Kuwamai/micromouse_ocelli/circuit_diagram/block_diagram.drawio.png

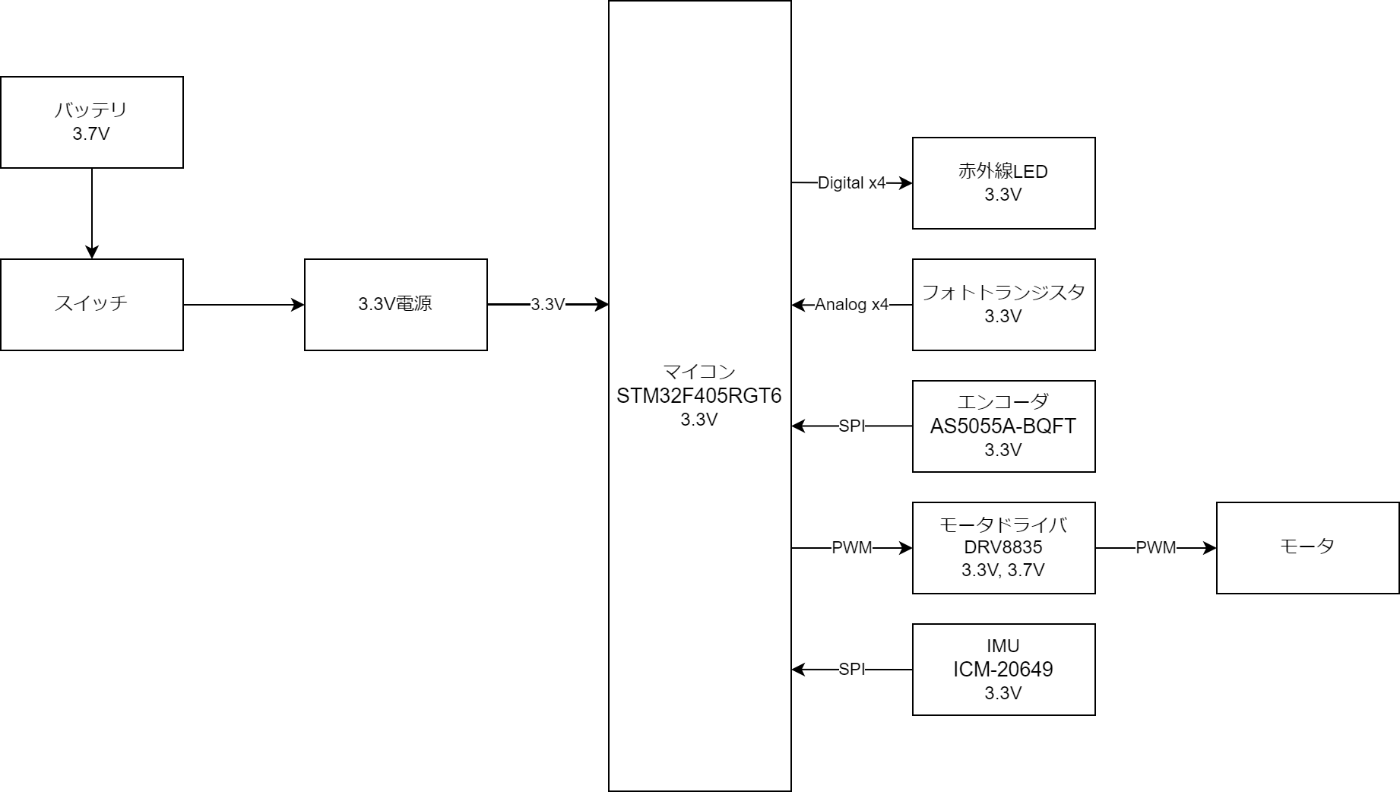
circuit_diagram/block_diagram.drawio.png
