Kuwamai/micromouse_ocelli/circuit_diagram/ocelli_board.dxf

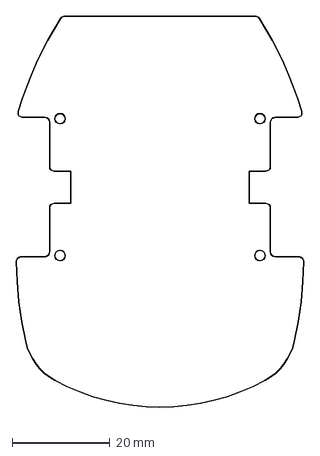
[picture p2: CAD file, 2022-10-17]
circuit_diagram/ocelli_board.dxf
58.8 x 81.8 mm
