Kuwamai/micromouse_ocelli/circuit_diagram/ocelli_parts.dxf

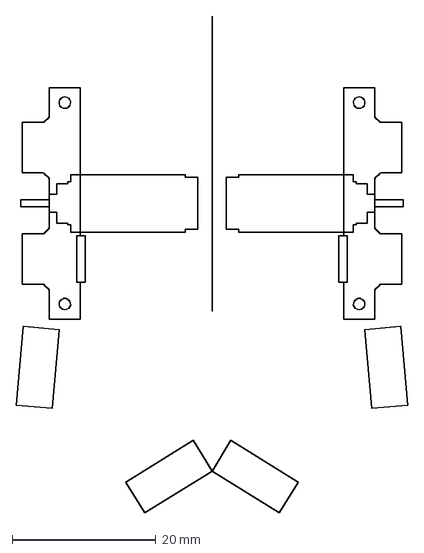
[picture p3: CAD file, 2022-10-17]
circuit_diagram/ocelli_parts.dxf
54.4 x 69.0 mm
