Kuwamai/micromouse_ocelli/(threads)

Thread 12 (2021-10-04):

機体設計

Kuwamai, 2021-10-04:
- [x] ネジの選定
    - [鉄(三価クロメート) ＋低頭精密小ねじ(ラミクス) FX-0000E【ウィルコ-WILCO-】ねじ(ネジ)の通販・販売](https://wilco.jp/products/F/FX-E.html#page3)
    - [ネジやボルトの必要最低長さ計算方法 | alumania INFORMATION](https://info.alumania.net/diy/%E3%83%8D%E3%82%B8%E9%95%B7%E3%81%95%E3%81%AE%E7%B0%A1%E6%98%93%E8%A8%88%E7%AE%97%E6%96%B9%E6%B3%95%E3%81%A8%E6%97%A9%E8%A6%8B%E8%A1%A8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)
        - ネジの長さはネジ径x1.5なのでM2ネジ長さは3mm
- [x] モータマウントの外形決め
- [x] センサ配置検討
- [x] 基板のおおよそのサイズ決定

Kuwamai, 2021-11-04:
基板の厚さは標準的な1.6mm
迷路内の段差は最大1mmあるので車高はそれ以上にする

Kuwamai, 2022-04-13:
Fusion360を使った設計の流れ
* [Fusion360で設計するマイクロマウス①：マウス研修（しおたに）32 | アールティ　移動型ロボットブログ](https://rt-net.jp/mobility/archives/13979)
* [Fusion360で設計するマイクロマウス②：マウス研修（しおたに）33 | アールティ　移動型ロボットブログ](https://rt-net.jp/mobility/archives/13981)
* [Fusion360で設計するマイクロマウス③：マウス研修（しおたに）34 | アールティ　移動型ロボットブログ](https://rt-net.jp/mobility/archives/14798)
* [Fusion360で設計するマイクロマウス④：マウス研修（しおたに）35 | アールティ　移動型ロボットブログ](https://rt-net.jp/mobility/archives/15145)

Kuwamai, 2022-04-13:
エンコーダの配置を決めるためモータマウントを優先して設計
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

Kuwamai, 2022-04-13:
エンコーダの配置参考
* [ショウのマイクロマウス制作-Part19 | アールティ　移動型ロボットブログ](https://rt-net.jp/mobility/archives/16338)
* [ショウのマイクロマウス制作-Part31 | アールティ　移動型ロボットブログ](https://rt-net.jp/mobility/archives/20573)

Closed 2023-02-21.

Thread 3 (2021-10-04):

ギヤ比、歯数を決める

Kuwamai, 2021-10-04:
目標加速度、速度からギヤ比を決める
ホイールのサイズからスパーギヤの歯数を決める
モジュールは3Dプリンタで制作しやすい0.5にする

Kuwamai, 2021-11-02:
ギヤ比計算式: https://rt-net.jp/mobility/archives/12621
モータ: https://www.shinkoh-faulhaber.jp/products/series/0816sr
ギヤ比: 1.7
目標最高速度: 5m/s
目標最高加速度: 20m/s/s
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

Kuwamai, 2021-11-02:
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

Kuwamai, 2021-11-02:
スパーギヤが22の場合ギヤ比1.7を満たすピニオンは22/1.7=12.9411なので13になる。

Kuwamai, 2021-12-02:
最大加速度と最高速度を出力するために必要な電圧を別々に計算していたけど、台形加速で速度制御する際は最大加速度と最高速度を同時に出力する必要があった。そこでギヤ比を計算し直したところギヤ比3になった。もっと速度出せそうだったら2くらいにしてもいいかも。
ギヤ比: 3
機体重量: 0.05kg
最大加速度: 10m/s/s
最高速度: 1.6m/s
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

Kuwamai, 2021-12-02:
ギヤ比変更の影響でM0.5をM0.3に変更。DMMのプリントサービスを利用する。
https://make.dmm.com/print/material/2/

Kuwamai, 2021-12-02:
スパーギヤは11/0.3-2=34.666なので34
ピニオンギヤは34/3=11.333なので11

Kuwamai, 2021-12-07:
HMキットだとホイールの外寸は10mm。ゴムの厚みは1.8mmなのでタイヤ径は13.6mmがずれにくくていいかも。
https://www.rt-shop.jp/index.php?main_page=product_info&products_id=3643

Kuwamai, 2021-12-09:
HMキットを参考に車輪径を考慮しなおしたもの
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

Closed 2022-09-12.

Thread 4 (2021-10-04):

開発環境構築

Kuwamai, 2021-10-04:
- OpenOCD
  - [環境構築 – しゅうの自作マウス研修 part3 | アールティ　移動型ロボットブログ](https://rt-net.jp/mobility/archives/16130)
  - [Lチカ – しゅうの自作マウス研修 part4 | アールティ　移動型ロボットブログ](https://rt-net.jp/mobility/archives/16231)
  - [環境構築とLチカ （STM32/Makefile/VSCode） – 元Web屋のマウス製作記 Part.15 | アールティ　移動型ロボットブログ](https://rt-net.jp/mobility/archives/9940)
  - [STM32をVSCode & PlatformIO (C++) で開発する - いろいろつくるよ](https://iroiro-craft.hatenablog.com/entry/2022/06/04/172802)

- CubeIDE
  - [マイクロマウス研修(のり)[15]STM32F446開発環境構築 | アールティ　移動型ロボットブログ](https://rt-net.jp/mobility/archives/11816)
  - [マイクロマウス研修(のり)[16]STM32F446書込&デバッグ | アールティ　移動型ロボットブログ](https://rt-net.jp/mobility/archives/12122)

- OpenCFDの設定ファイルは`/usr/share/openocd/scripts`にある
  - [OpenOCD + ST-LinkでFirmware書き込み - ryochack.blog](https://ryochack.hatenablog.com/entry/2017/11/03/234216)
- 書き込み機の改造
  - [stlink\_usb.c:773 stlink\_usb\_init\_mode(): target voltage may be too low for reliable debugging](https://community.st.com/s/question/0D50X00009XkdhFSAR/stlinkusbc773-stlinkusbinitmode-target-voltage-may-be-too-low-for-reliable-debugging)

Kuwamai, 2023-01-12:
Nucleo boardの上半分とOpenOCDによる書き込みを試したが何故か失敗するのでCubeIDEを使用して開発を進める

Kuwamai, 2023-02-01:
Cube IDEのインデント幅設定。BSD/Allmanのインデント幅を2にした。
- [STM32 IDE 知って得する小技たち │ moon's STM32づくし](https://moons.link/post-1143/)

Closed 2023-01-12.

Thread 6 (2021-10-04):

ADC

Kuwamai, 2021-10-04:
壁センサや電圧監視の動作確認

Kuwamai, 2023-02-02:
- [マイクロマウス研修(のり)[32]STM32F446 STEP3-1 ADC(シングル) | アールティ　移動型ロボットブログ](https://rt-net.jp/mobility/archives/19081)
- [マイクロマウス研修(のり)[33]STM32F446 STEP3-2 ADC(複数チャンネル) | アールティ　移動型ロボットブログ](https://rt-net.jp/mobility/archives/19153)
  - とりあえずこれで実装してみる
- [マイクロマウス研修(のり)[34]STM32F446 STEP3-3 ADC(DMA) | アールティ　移動型ロボットブログ](https://rt-net.jp/mobility/archives/19257)

Kuwamai, 2023-02-06:
コレクタ-エミッタ間
3.299->3.209

GND-エミッタ間
34->511mv

GND-アナログピン間
0mv?

Kuwamai, 2023-02-07:
フォトトランジスタの立ち上がりまでの時間やdelay_usについて記述

Kuwamai, 2023-02-08:
正確なdelay関数を作りたい
参考: [Microsecond/Nanoseconds delay in STM32 » ControllersTech](https://controllerstech.com/create-1-microsecond-delay-stm32/)
TIM1は使ってるのでTIM2にする。TIM2はAPB1を使っており84MHz。prescaler 84-1で作成。
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

Kuwamai, 2023-02-08:
- [マイクロマウス研修(のり)[34]STM32F446 STEP3-3 ADC(DMA) | アールティ　移動型ロボットブログ](https://rt-net.jp/mobility/archives/19257)
- DMAのやつにした
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

Closed 2023-02-12.

Thread 7 (2021-10-04):

PWM

Kuwamai, 2021-10-04:
- [STM32でDCモータを回す – 元Web屋のマイクロマウス製作記 Part.18 | アールティ　移動型ロボットブログ](https://rt-net.jp/mobility/archives/10557)
  - PWM周波数[Hz] = （クロックソース[Hz] / プリスケーラ） / カウンタピリオド
  - PWM(200kHz) = (16Mhz / 16) / 5
- AHB ClockはMAXまで上げて問題ない
  - 多少消費電流が増えるがバッテリが小さくなければOK
  - 16 MHz→168 MHz

Kuwamai, 2023-01-12:
PWM周波数1kHz
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
↓
PWM周波数168kHz
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

Kuwamai, 2023-01-12:
```
  while (1)
  {
    HAL_GPIO_TogglePin(GPIOC, GPIO_PIN_6);
    HAL_GPIO_TogglePin(GPIOC, GPIO_PIN_7);
    //HAL_GPIO_TogglePin(GPIOC, GPIO_PIN_8);
    //HAL_GPIO_TogglePin(GPIOC, GPIO_PIN_9);
    HAL_GPIO_TogglePin(GPIOA, GPIO_PIN_10);
    __HAL_TIM_SET_COMPARE(&htim1, TIM_CHANNEL_4, 250);
    HAL_TIM_PWM_Start(&htim1, TIM_CHANNEL_4);
    HAL_GPIO_TogglePin(GPIOA, GPIO_PIN_8);
    __HAL_TIM_SET_COMPARE(&htim1, TIM_CHANNEL_2, 250);
    HAL_TIM_PWM_Start(&htim1, TIM_CHANNEL_2);
    HAL_Delay(1000);
    HAL_TIM_PWM_Stop(&htim1, TIM_CHANNEL_4);
    HAL_TIM_PWM_Stop(&htim1, TIM_CHANNEL_2);
    HAL_Delay(1000);
    /* USER CODE END WHILE */

    /* USER CODE BEGIN 3 */
  }
```

Kuwamai, 2023-01-12:
- TIM1のクロック
  - https://www.st.com/resource/en/datasheet/dm00037051.pdf 19P
- DRV8835のPWM周波数上限
  - https://www.ti.com/jp/lit/ds/symlink/drv8835.pdf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 P5

Kuwamai, 2023-01-12:
- その他ブログネタ
  - モータの出力軸根本についている出っ張りがモータ本体に固定されていると思ったら出力軸側だった
  - 出っ張りとモータマウンタを接触させて位置合わせしていたためモータをモータマウンタに固定するとモータが回転しなくなってしまった
  - 位置合わせ用の穴を2.5mm→3mmに拡大して出っ張りとモータマウンタの接触を修正した
  - モータの配線はコネクタ使ったほうがいいよねの話
  - モータの配線に熱収縮チューブつければよかったねの話

Closed 2023-01-12.

Thread 8 (2021-10-04):

IMU

Kuwamai, 2021-10-04:
- ICM-20649データセット
  - https://product.tdk.com/system/files/dam/doc/product/sensor/mortion-inertial/imu/data_sheet/ds-000192-icm-20649-v1.1.pdf
  - MSB【Most Significant Bit】
  - LSB【Least Significant Bit】

Kuwamai, 2023-01-13:
まずはセンサ値を確認するためデバッグモードの動作確認をした
- [マイクロマウス研修(のり)[16]STM32F446書込&デバッグ | アールティ　移動型ロボットブログ](https://rt-net.jp/mobility/archives/12122)
- [STM32CubeIDEでのデバッグ - Qiita](https://qiita.com/infinite1oop/items/98e512adbeadc7136efe)
```
  while (1)
  {
    HAL_GPIO_TogglePin(GPIOC, GPIO_PIN_6);
    HAL_GPIO_TogglePin(GPIOC, GPIO_PIN_7);
    for(int i = 0; i < 5; i++)
    {
      HAL_GPIO_TogglePin(GPIOC, GPIO_PIN_8);
      HAL_GPIO_TogglePin(GPIOC, GPIO_PIN_9);
      HAL_Delay(200);
    }
    /*
    HAL_GPIO_TogglePin(GPIOA, GPIO_PIN_10);
    __HAL_TIM_SET_COMPARE(&htim1, TIM_CHANNEL_4, 250);
    HAL_TIM_PWM_Start(&htim1, TIM_CHANNEL_4);
    HAL_GPIO_TogglePin(GPIOA, GPIO_PIN_8);
    __HAL_TIM_SET_COMPARE(&htim1, TIM_CHANNEL_2, 250);
    HAL_TIM_PWM_Start(&htim1, TIM_CHANNEL_2);
    HAL_Delay(1000);
    HAL_TIM_PWM_Stop(&htim1, TIM_CHANNEL_4);
    HAL_TIM_PWM_Stop(&htim1, TIM_CHANNEL_2);
    HAL_Delay(1000);
    */
    /* USER CODE END WHILE */

    /* USER CODE BEGIN 3 */
  }
```

Kuwamai, 2023-01-13:
- [マイクロマウス研修(のり)[39]STM32F446 STEP7-1 SPI | アールティ　移動型ロボットブログ](https://rt-net.jp/mobility/archives/19984)
- データセットと照らし合わせながら設定方法を解説している
- 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
- PWMと違って通信速度が表示されるのでいい
- 僕は7MHzが上限なので8を設定

Kuwamai, 2023-01-16:
のりさんのコードのアドレス部分を書き換えたらWHO_AM_Iできた
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

Kuwamai, 2023-01-18:
- [マイクロマウス研修(のり)[39]STM32F446 STEP7-2 SPI(IMU) | アールティ　移動型ロボットブログ](https://rt-net.jp/mobility/archives/20145)
  - 引き続きのりさんのブログを見て角速度が取得できた

Kuwamai, 2023-01-18:
gitignoreは基本的にEclipseのものでOK
https://github.com/github/gitignore/blob/main/Global/Eclipse.gitignore

Kuwamai, 2023-01-18:
```
  /* USER CODE BEGIN WHILE */
  while (1)
  {
    HAL_GPIO_TogglePin(GPIOC, GPIO_PIN_6);
    HAL_GPIO_TogglePin(GPIOC, GPIO_PIN_7);

    address = 0x37 | 0b10000000;
    HAL_GPIO_WritePin(GPIOD, GPIO_PIN_2, GPIO_PIN_RESET);
    HAL_SPI_Transmit(&hspi3, &address, 1, 100);
    HAL_SPI_Receive(&hspi3, &data_h, 1, 100);
    HAL_GPIO_WritePin(GPIOD, GPIO_PIN_2, GPIO_PIN_SET);
    HAL_Delay(50);

    address = 0x38 | 0b10000000;
    HAL_GPIO_WritePin(GPIOD, GPIO_PIN_2, GPIO_PIN_RESET);
    HAL_SPI_Transmit(&hspi3, &address, 1, 100);
    HAL_SPI_Receive(&hspi3, &data_l, 1, 100);
    HAL_GPIO_WritePin(GPIOD, GPIO_PIN_2, GPIO_PIN_SET);
    HAL_Delay(50);

    gyro_z = ((int16_t)((uint16_t)data_h<<8)) | ((int16_t)((uint16_t)data_l&0x00ff));
    gyro_z_ang_vel = (float)gyro_z / 65.5;
  }
```

Kuwamai, 2023-01-20:
- [ESP32マウスPart.37　C++でESP32を動かす（SPIでモーションセンサと通信する） | アールティ　移動型ロボットブログ](https://rt-net.jp/mobility/archives/10865)
- [ESP32マウスPart.38　C++でESP32を動かす（ICM-20648のライブラリ作成） | アールティ　移動型ロボットブログ](https://rt-net.jp/mobility/archives/11487)
- [モータ周りとIMUの回路設計– はしもとの自作マウス研修 Part13 | アールティ　移動型ロボットブログ](https://rt-net.jp/mobility/archives/22017)
- [ジャイロってなんじゃろ？– HM-StarterKit入門 Part 9 | アールティ　移動型ロボットブログ](https://rt-net.jp/mobility/archives/17327)
- [ドライバとコントローラの実装 – ししかわのマウス研修 Part.46 | アールティ　移動型ロボットブログ](https://rt-net.jp/mobility/archives/16072)
- [M5Mouse/gyro.c at master · meganetaaan/M5Mouse](https://github.com/meganetaaan/M5Mouse/blob/master/mouse/Core/Src/drivers/gyro.c)
- [マイクロマウス研修（kora編）[8]ジャイロとエンコーダ | アールティ　移動型ロボットブログ](https://rt-net.jp/mobility/archives/6396)

Closed 2023-01-19.

Thread 9 (2021-10-04):

エンコーダ

Kuwamai, 2021-10-04:
* 5047の記事
  * [マイクロマウスの磁気式エンコーダの設計をしてみる | Sora's Activity Record](https://garberas.com/archives/2218)
  * [AS5047P | ams](https://ams.com/ja/as5047p#tab/documents)
  * [data sheet](https://ams.com/documents/20143/36005/AS5047P_DS000324_3-00.pdf)
* [AS5055A Small size, low power rotary position sensor, hall sensor - ams | ams](https://ams.com/ja/as5055a#tab/documents)
  * 購入したエンコーダ
  * [data sheet](https://ams.com/documents/20143/36005/AS5055A_DS000304_2-00.pdf/edb580b0-2a7b-ba9f-1b35-139255db4272)
* HM-Kitは5050
  * [ハーフマウス研修　その13エンコーダの再選定 | アールティ　移動型ロボットブログ](https://rt-net.jp/mobility/archives/4192)
* [Magnet Selection Guide](https://ams.com/documents/20143/36005/AnglePositionOnAxis_AN000271_2-00.pdf/d3bc1235-a3da-7e15-15bf-624e9ff0c389)

Kuwamai, 2022-04-18:
* [マイクロマウスの磁気式エンコーダの設計をしてみる | Sora's Activity Record](https://garberas.com/archives/2218)
  * 磁石サイズや距離、モータマウントの設計、市販の部品など紹介されている
* [マイクロマウス導入技術～磁気式エンコーダ～ | Haratta Tech Lab](https://haratta-tech-lab.com/magnetic-encoder/)
  * エンコーダの線形性、精度について紹介されている
* [磁気式エンコーダ　その１ - エヌがのロボット製作日記](https://megato.hatenablog.com/entry/2015/11/29/023020)
* [磁気式エンコーダ　その２ - エヌがのロボット製作日記](https://megato.hatenablog.com/entry/2015/11/29/171715)
* [磁気式エンコーダ　その３ - エヌがのロボット製作日記](https://megato.hatenablog.com/entry/2015/12/04/035435)
  * センサの補正についてまとめられている
  * モータを互い違いに配置している
* [まついのまうす製作録: AS5040のマウス用途開発(1)](http://matsui-mouse.blogspot.com/2012/11/as50401.html)
* [まついのまうす製作録: AS5040のマウス用途開発(2)](http://matsui-mouse.blogspot.com/2012/12/as50402.html)
* [まついのまうす製作録: AS5040のマウス用途開発(3)](http://matsui-mouse.blogspot.com/2012/12/as50403_24.html)
  * エンコーダ用基板とメイン基板をつなぐパッド位置などまとめられている

Kuwamai, 2023-01-16:
HIGHではなくLOWかも

Kuwamai, 2023-01-20:
HM-KitがASシリーズ使ってるらしいのでAS5055買ったけど、みんなMA702使ってるし現行のHM-KitもMA702だったよトホホ〜

Kuwamai, 2023-01-26:
- Live Expressionでリアルタイムに値を確認できる
- [STM32CubeIDEを使ってみよう　How To STM32CubeIDE 日本語版　(3) - Qiita](https://qiita.com/usashirou/items/e1cb59a508dac64b8a3c)

Kuwamai, 2023-01-26:
こうすれば16 bit送れる？
[Send 16 bit number with SPI and HAL library](https://community.st.com/s/question/0D50X00009Xkf5JSAR/send-16-bit-number-with-spi-and-hal-library)

Kuwamai, 2023-01-27:
クロックを確認したらGNDが浮いているような挙動をしている。MISOとSCLKがショートしているようなので要確認。
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

Kuwamai, 2023-01-27:
IMUは最初の8bitでアドレス、それ以降のクロックでデータを送り返す仕様になっていた。そのためTransmitとReceiveは別に表記されていた。↑のクロックが複数あるのはそのせい。

エンコーダは受信のために一度CSを立ち上げる必要がある（P11）
受信と送信が同時に行われる（P15とかFigure17とか。）
そのためTransmitとReceiveを別に実行せず同時に実行する必要がある。

Kuwamai, 2023-01-30:
ショートしてそうな場所を見つけたので除去した。テスターで確認したところショートしてないっぽい

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

Kuwamai, 2023-02-01:
これで値がとれた
```
int16_t encoder_l;
int16_t encoder_r;
uint16_t data;
  while (1)
  {
    HAL_GPIO_TogglePin(GPIOC, GPIO_PIN_6);
    HAL_GPIO_TogglePin(GPIOC, GPIO_PIN_7);
    uint16_t address = 0xFFFF;

    HAL_GPIO_WritePin(GPIOC, GPIO_PIN_1, GPIO_PIN_RESET);
    HAL_SPI_TransmitReceive(&hspi2, (uint8_t*)&address, (uint8_t*)&data, 1, 100);
    HAL_GPIO_WritePin(GPIOC, GPIO_PIN_1, GPIO_PIN_SET);
    HAL_Delay(50);
    encoder_l = (data & 0b0011111111111100) >> 2;

    HAL_GPIO_WritePin(GPIOC, GPIO_PIN_13, GPIO_PIN_RESET);
    HAL_SPI_TransmitReceive(&hspi2, (uint8_t*)&address, (uint8_t*)&data, 1, 100);
    HAL_GPIO_WritePin(GPIOC, GPIO_PIN_13, GPIO_PIN_SET);
    HAL_Delay(50);
    encoder_r = (data & 0b0011111111111100) >> 2;
    /* USER CODE END WHILE */

    /* USER CODE BEGIN 3 */
  }
```

Kuwamai, 2023-02-01:
角度読むだけだと不要だけどパリティビットの計算方法
- [C#講座　RS405CB動く！ | RT Robot Shop Blog](https://www.rt-shop.jp/blog/archives/3272)
- [効率の良いパリティ計算方法 - Qiita](https://qiita.com/shiozaki/items/e803483cbd8b3c6ab28d)
- [パリティビットの意味と誤り検出、誤り訂正の方法 - 具体例で学ぶ数学](https://mathwords.net/paritycheck)

Closed 2023-02-01.

Thread 13 (2022-07-06):

回路図作成

Kuwamai, 2022-07-06:
モジュールごとに設計する
- [x] フォトリフレクタ
    - [５ｍｍ赤色ＬＥＤ　６２４ｎｍ　１５度　ＯＳ５ＲＫＡ５１１１Ａ　（１０個入）: LED(発光ダイオード) 秋月電子通商-電子部品・ネット通販](https://akizukidenshi.com/catalog/g/gI-04768/)
    - [コーデンシ製フォトトランジスタST-1KL3A　4個入り [ST-1KL3A\_4] - ￥1,320](https://www.rt-shop.jp/index.php?main_page=product_info&products_id=2746)
    - [ＮｃｈＭＯＳＦＥＴ　５０Ｖ３００ｍＡ　ＢＳＳ１３８　Ｐａｎｊｉｔ製　（２５個入）: 半導体(モジュール) 秋月電子通商-電子部品・ネット通販](https://akizukidenshi.com/catalog/g/gI-04232/)
    - 板Pi:Coと同じ構成
- [x] モータドライバ
    - 参考: [M5Stackマイクロマウスの回路設計：DRV8835を使ったモータドライバ回路 – ししかわのマウス研修 Part.35 | アールティ　移動型ロボットブログ](https://rt-net.jp/mobility/archives/14884)
    - [DRV8835 のデータシート、製品情報、およびサポート | TI.com](https://www.ti.com/product/ja-jp/DRV8835)
- [x] IMU
    - 参考: [M5Stackマイクロマウスの回路設計：ICM-20648を使ったIMU回路 – ししかわのマウス研修 Part.36 | アールティ　移動型ロボットブログ](https://rt-net.jp/mobility/archives/15211)
    - SPI通信の略語: [マイクロマウス研修(のり)[39]STM32F446 STEP7-1 SPI | アールティ　移動型ロボットブログ](https://rt-net.jp/mobility/archives/19984)
    - [Data sheet: Typical Operating Circuit](https://product.tdk.com/system/files/dam/doc/product/sensor/mortion-inertial/imu/data_sheet/ds-000192-icm-20649-v1.0.pdf)
- [x] エンコーダ
    - [AS5055A Small size, low power rotary position sensor, hall sensor - ams | ams](https://ams.com/ja/as5055a)
    - [ESP32マウスPart.36　SPIで磁気式エンコーダMA702を使う | アールティ　移動型ロボットブログ](https://rt-net.jp/mobility/archives/10454)
    - [ショウのマイクロマウス制作-Part29 | アールティ　移動型ロボットブログ](https://rt-net.jp/mobility/archives/19171)
    - IMUとエンコーダのSPIをわけておくと万が一仕様が異なっていても大丈夫
- [x] マイコン
    - [STM32F405RGT6｜製品情報（STM32）｜STM32, STM8ファミリはSTの32bit／8bit汎用マイクロコントローラ製品](https://www.stmcu.jp/stm32/stm32f4/stm32f405415/12229/)
    - 書き込みコネクタ
        - [M5Stackマイクロマウスの回路設計：M5StackとSTM32周辺回路 – ししかわのマウス研修 Part.37 | アールティ　移動型ロボットブログ](https://rt-net.jp/mobility/archives/15317)
        - [マイクロマウス研修(のり)[2]STM32F446データシート | アールティ　移動型ロボットブログ](https://rt-net.jp/mobility/archives/10003)
        - [マイクロマウス研修(のり)[3]STM32F446回路設計 | アールティ　移動型ロボットブログ](https://rt-net.jp/mobility/archives/10171)
            - マイコンへの電源供給まわりも参考にした
        - [ショウのマイクロマウス制作-Part18 | アールティ　移動型ロボットブログ](https://rt-net.jp/mobility/archives/16024)
        - [書き込み用ピン - P30](https://www.st.com/content/ccc/resource/technical/document/application_note/76/f9/c8/10/8a/33/4b/f0/DM00115714.pdf/files/DM00115714.pdf/jcr:content/translations/en.D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)
        - [NUCLEO boardをST-Linkとして使う - P19](https://www.st.com/resource/en/user_manual/um1724-stm32-nucleo64-boards-mb1136-stmicroelectronics.pdf)
    - 書き込み時の出力(reset value)を気にしないと書き込むたびにマウスが走り出したりする
        - P287
        - https://www.st.com/resource/en/reference_manual/dm00031020-stm32f405-415-stm32f407-417-stm32f427-437-and-stm32f429-439-advanced-arm-based-32-bit-mcus-stmicroelectron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
- [x] LED
    - [赤色チップＬＥＤ　［１６０８］　６２５ｎｍ　１２０度　ＯＳＨＲ１６０８　（２０個入）: LED(発光ダイオード) 秋月電子通商-電子部品・ネット通販](https://akizukidenshi.com/catalog/g/gI-03978/)
    - [青色チップＬＥＤ　［１６０８］　ＯＳＢＬ１６０８　（２０個入）: LED(発光ダイオード) 秋月電子通商-電子部品・ネット通販](https://akizukidenshi.com/catalog/g/gI-03982/)
    - [黄色チップＬＥＤ　［１６０８］　ＯＳＹＬ１６０８　（２０個入）: LED(発光ダイオード) 秋月電子通商-電子部品・ネット通販](https://akizukidenshi.com/catalog/g/gI-03984/)
        - 黄色と青のカラフルな感じに出来たらいいな
- [x] 電源
    - [低損失表面実装型三端子レギュレーター　３．３Ｖ８００ｍＡ　ＮＪＭ２８４５ＤＬ１－３３: 半導体(モジュール) 秋月電子通商-電子部品・ネット通販](https://akizukidenshi.com/catalog/g/gI-11299/)
    - [ＰｃｈパワーＭＯＳＦＥＴ　６０Ｖ８Ａ　ＴＪ８Ｓ０６Ｍ３Ｌ: 半導体(モジュール) 秋月電子通商-電子部品・ネット通販](https://akizukidenshi.com/catalog/g/gI-13964/)
    - 板Pi:Coを参考
- [x] スイッチ
    - [表面実装用タクトスイッチ　ＴＳ－０６１０４: パーツ一般 秋月電子通商-電子部品・ネット通販](https://akizukidenshi.com/catalog/g/gP-15969/)
- [x] ブザー
    - [表面実装圧電サウンダ　ＰＫＭＣＳ０９０９Ｅ４０００－Ｒ１: パーツ一般 秋月電子通商-電子部品・ネット通販](https://akizukidenshi.com/catalog/g/gP-14238/)
    - 板Pi:Co参考
- [x] ~~水晶発振子~~
    - USB通信等クロックに高い精度が求められることをしないので今回は使用しない
    - [クリスタル（水晶振動子）　８ＭＨｚ　（５個入）: パーツ一般 秋月電子通商-電子部品・ネット通販](https://akizukidenshi.com/catalog/g/gP-17131/)
    - [表面実装型クリスタル（水晶発振子）　８ＭＨｚ　（５個入）: パーツ一般 秋月電子通商-電子部品・ネット通販](https://akizukidenshi.com/catalog/g/gP-01340/)
    - [表面実装型クリスタル（水晶発振子）　３２．７６８ｋＨｚ　（４個入）: パーツ一般 秋月電子通商-電子部品・ネット通販](https://akizukidenshi.com/catalog/g/gP-03004/)
- [x] バッテリー
    - [300mAh](https://www.amazon.co.jp/dp/B09B4T26YX?ref_=cm_sw_r_cp_ud_dp_KEJTHVFV9VXGP1RECBQ0)
- [x] フェライトビーズ
    - [MZ1608-102Y Bourns Inc. | フィルタ | DigiKey](https://www.digikey.jp/ja/products/detail/bourns-inc/MZ1608-102Y/1970477)
    - 参考: [マイクロマウス研修(のり)[8]KiCAD部品表出力 | アールティ　移動型ロボットブログ](https://rt-net.jp/mobility/archives/10774)

Kuwamai, 2022-07-07:
回路設計の進め方
1. 回路ブロック図を考える
2. ブロックごとに主要なICを選定してブロック図に書き込んでいく
3. ブロックごとに回路設計を行う
    - ICのサンプル回路が参考になると思う
    - Pin functionのページに接続する部品が書いてあったりするのでそちらも参考に
    - 抵抗やコンデンサなど細かい素子の選定は置いておく
    - 他のモジュールと共通してる場合があるため
    - 同じ容量のコンデンサが4種類あるとか避けたい

Kuwamai, 2022-07-20:
KiCAD用gitignore
* [gitignore/Unity.gitignore at main · github/gitignore](https://github.com/github/gitignore/blob/main/Unity.gitignore)

Kuwamai, 2022-08-17:
参考回路図
- [M5Mouse/m5mouse.pdf at master · meganetaaan/M5Mouse](https://github.com/meganetaaan/M5Mouse/blob/master/schematics/m5mouse/m5mouse.pdf)

Kuwamai, 2022-08-29:
- 抵抗
    - 抵抗値、定格電力、精度
    - [【抵抗器】電子工作で最もよく使われる部品の一つ | 電子工作[超]入門 Lab.](https://sanuki-tech.net/make-electronics/parts/resistor/)
        - 抵抗の定格電力は消費電力の倍以上にしておく
        - 余裕をもたせることをディレーティングという
        - 消費電力は`P = V * V / R`で求める
    - [抵抗の適切な選定方法｜EMC村の民](https://engineer-climb.com/resistor-choice/)
        - 抵抗値が大きい場合は最高過負荷電圧も気にする
- コンデンサ
    - 容量、耐圧、精度

Closed 2022-09-01.

Thread 15 (2022-09-12):

回路パターン作成

Kuwamai, 2022-09-12:
- [x] 基板外形設計
- [x] 部品配置
- [x] 配線

Kuwamai, 2022-09-12:
- [KiCad + FusionPCBで端面スルーホールを作る](http://idken.net/posts/2019-04-08-castellatedhole_kicad_fusionpcb/)
    - Castellated Hole
    - エンコーダ基板を立てる際の参考
    - とはいえここまでやる必要はなさそう

Kuwamai, 2022-09-13:
- [壁センサ取り付け角度について – マイクロマウス研修（槇原）Part6 | アールティ　移動型ロボットブログ](https://rt-net.jp/mobility/archives/21694)
    - 前壁センサは5度くらい外側がいいかも
- 基板外形をKiCADにインポート
    - [Fusion 360で作成した基板外形や3DモデルをKiCadにインポートする – マイクロマウス研修（槇原）Part7 | アールティ　移動型ロボットブログ](https://rt-net.jp/mobility/archives/21931)
    - [アートワーク：マウス研修（しおたに）43 | アールティ　移動型ロボットブログ](https://rt-net.jp/mobility/archives/19442)

Closed 2022-12-12.

Thread 22 (2023-02-12):

壁センサ割り込み

Kuwamai, 2023-02-12:

Kuwamai, 2023-02-12:
- [環境構築とLチカ （STM32/Makefile/VSCode） – 元Web屋のマウス製作記 Part.15 | アールティ　移動型ロボットブログ](https://rt-net.jp/mobility/archives/9940)
- https://github.com/meganetaaan/M5Mouse/blob/2c5171ce2254b4d0ba4cb0a5707e87bc41d1a45e/mouse/.vscode/c_cpp_properties.json
  - CubeIDEのエディタは操作に慣れていないのでVSCodeで補完機能とか有効にする設定をした

Kuwamai, 2023-02-13:
TIM1はPWM、TIM2はdelay_us、TIM3はブザー用に使っているのでTIM4、TIM5を使う。84MHz。

bit数が違うので設定できるCounter periodの上限が違う
TIM4 16 bit
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
TIM5 32 bit
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

Kuwamai, 2023-02-13:
- [割り込み処理 – しゅうの自作マウス研修 part14 | アールティ　移動型ロボットブログ](https://rt-net.jp/mobility/archives/18916)
- 割り込み用の関数がすでに生成されてるっぽい。のりさんはなぜif文で分岐するタイプにしたんだろうか。最終的なコードは違うと思うけど。

Kuwamai, 2023-02-14:
4kHz
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

Kuwamai, 2023-02-14:
バッテリー電圧調整用の係数をつくる
ADCの値: 3.67
電源の値: 3.711
調整用係数: 1.011

Kuwamai, 2023-02-14:
timとか必要なやつはexternつけて宣言する。

/* USER CODE BEGIN EV */
extern TIM_HandleTypeDef htim2;
/* USER CODE END EV */

Closed 2023-02-14.

Thread 34 (2023-02-21):

進行方向決定時に走行速度が遅くなる

Kuwamai, 2023-02-21:
迷路の区画ごとに一瞬速度が遅くなる。迷路サイズを32→16に変更したところ改善したためget_nexdirが怪しい。

Kuwamai, 2023-04-26:
直進時終了速度が0でない場合もモータをオフにしていた。そのためget_nexdir実行中モータが減速していた。
https://github.com/Kuwamai/micromouse_ocelli/blob/83a9e22b943191885c92ffddf3255ecb0ec523e4/program/mouse_program/Core/Src/run.c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

Closed 2023-04-26.

Thread 38 (2023-04-21):

探索走行中に自己位置がずれる

Kuwamai, 2023-04-21:
5区画走行すると4mmほど走行距離がのびる。これはget_nextdirの処理中に進んだ距離を計測していないためである。

Kuwamai, 2023-04-26:
探索時直進走行を始める前に走行距離をリセットしていたが、その直前に実行したget_nextdirの処理中に進んだ距離がリセットされていたためその分長く走行してしまっていた。
https://github.com/Kuwamai/micromouse_ocelli/blob/83a9e22b943191885c92ffddf3255ecb0ec523e4/program/mouse_program/Core/Src/run.c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

Closed 2023-04-26.
