Kuwamai/micromouse_ocelli/circuit_diagram/ocelli/ocelli.pdf

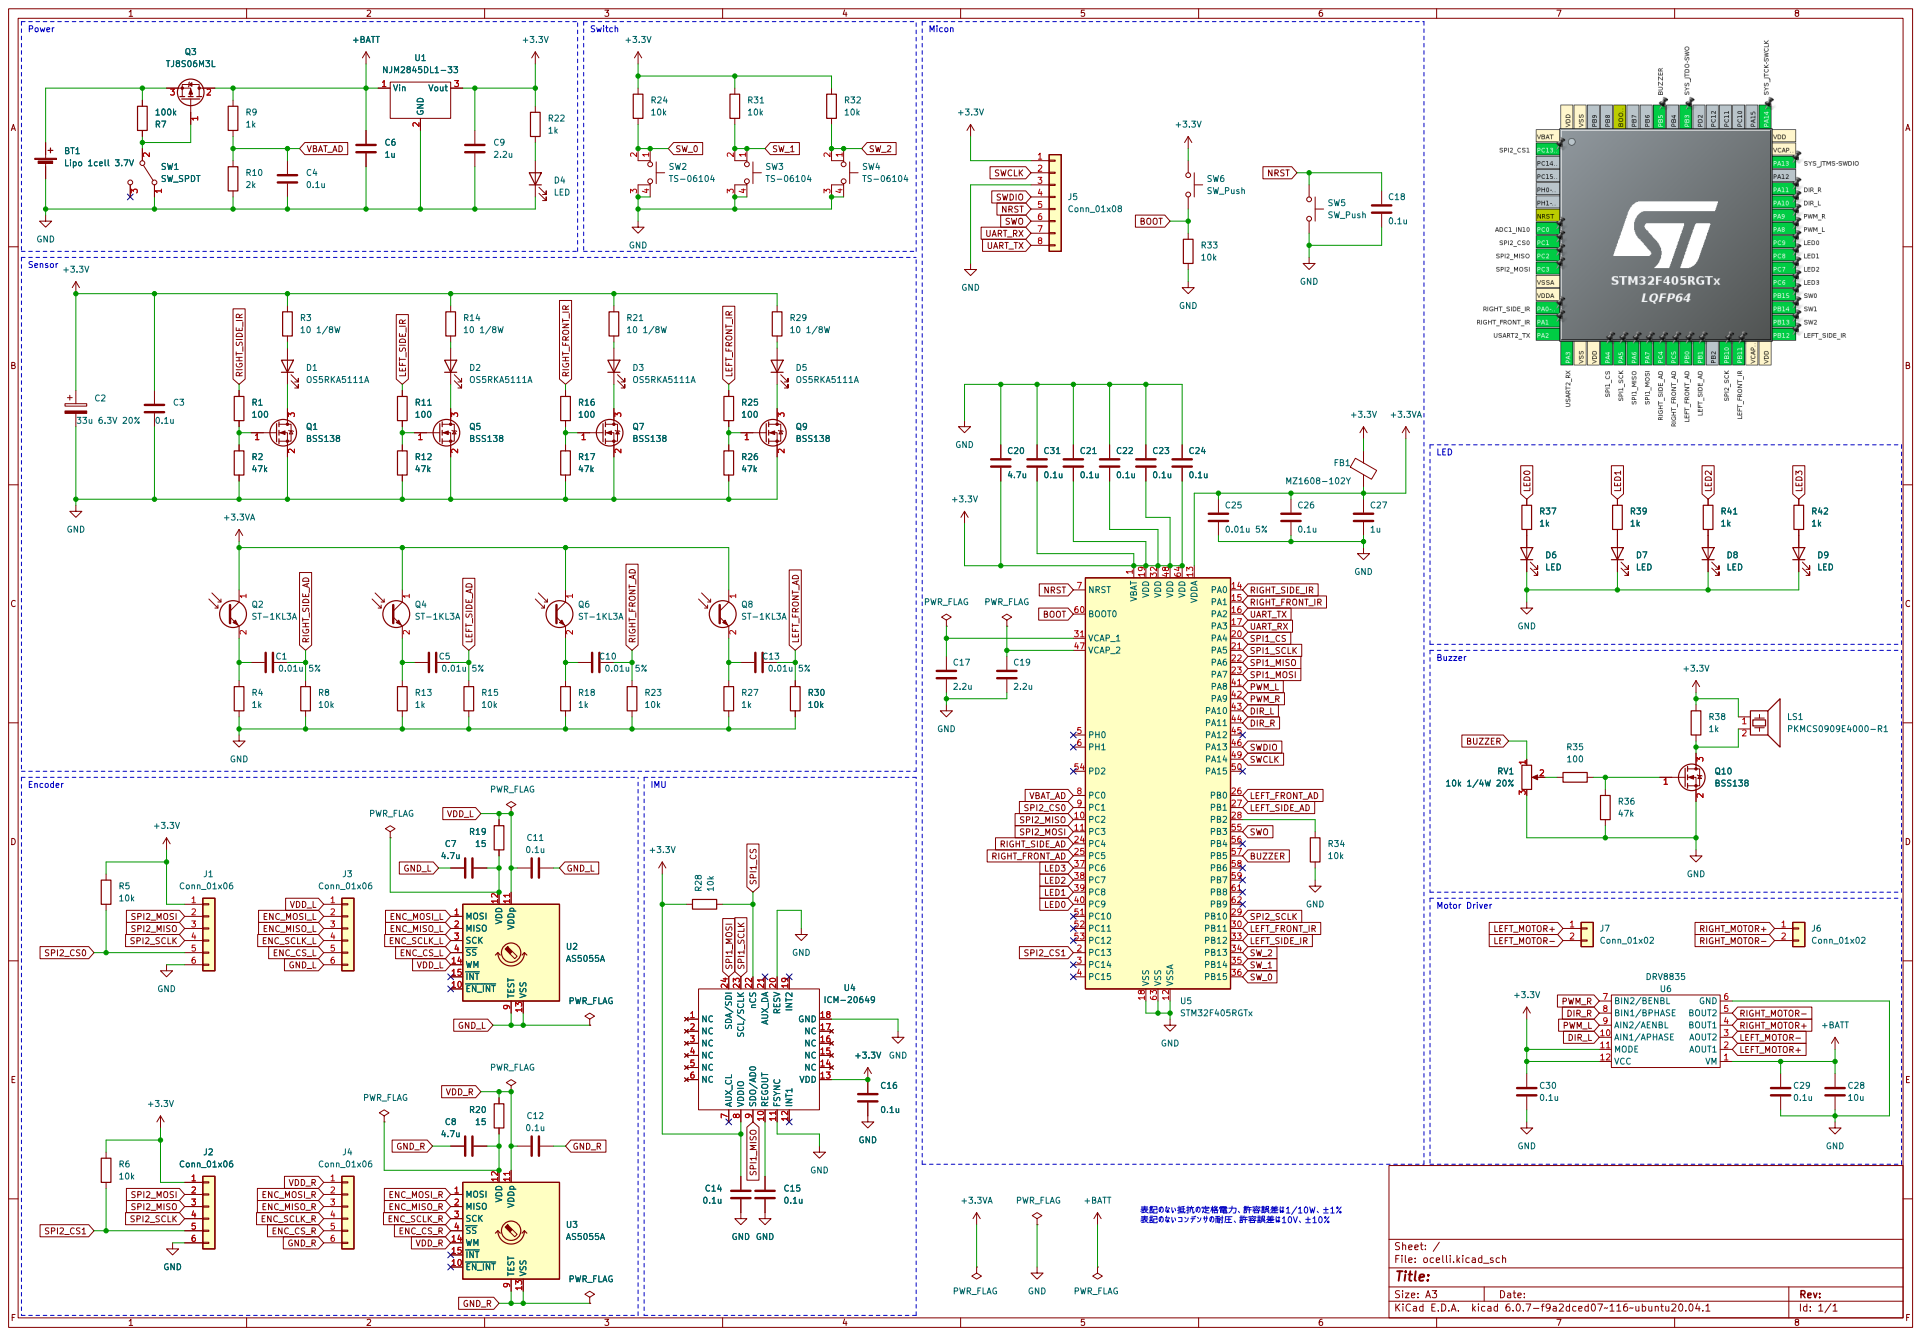
[picture p4: page 1]

2 3 Q9BSS138 MOSI 1 ~{EN_INT} 10 VDDp 11 VDD 12 VSS 13 WM 14 ~{INT} 15 MISO 2 SCK 3 ~{SS} 4 TEST

1 PC2 10 PC3 11 VSSA 12 VDDA 13 PA0 14 PA1 15 PA2 16 PA3 17 VSS 18 VDD 19 PC13 2 PA4 20 PA5 21 PA6 22 PA7 23 PC4 24 PC5 25 PB0 26 PB1 27 PB2 28 PB10 29 PC14 3 PB11 30 VCAP_1 31 VDD 32 PB12 33 PB13 34 PB14 35 PB15 36 PC6 37 PC7 38 PC8 39 PC15 4 PC9 40 PA8 41 PA9 42 PA10 43 PA11 44 PA12 45 PA13 46 VCAP_2 47 VDD 48 PA14 49 PH0 5 PA15 50 PC10 51 PC11 52 PC12 53 PD2 54 PB3 55 PB4 56 PB5 57 PB6 58 PB7 59 PH1 6 BOOT0 60 PB8 61 PB9 62 VSS 63 VDD 64 NRST 7 PC0 8 PC1 9 U5STM32F405RGTx C17

File: ocelli.kicad_sch Sheet: / GNDGND

þÿˆhŠ0n0j0Dbµb—0n[šh<–ûR›0Š1[¹Š¤]î0o1/10W0±1%
þÿˆhŠ0n0j0D0³0ó0Ç0ó0µ0n€W'0Š1[¹Š¤]î0o10V0±10%
