Kuwamai/micromouse_ocelli/program/mouse_program/Core/Src/main.c

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
/* Includes ------------------------------------------------------------------*/
#include "main.h"

/* USER CODE BEGIN Includes */
#include <delay_us.h>
#include <global.h>
#include <run.h>
/* USER CODE END Includes */

ADC_HandleTypeDef hadc1;
DMA_HandleTypeDef hdma_adc1;

SPI_HandleTypeDef hspi2;
SPI_HandleTypeDef hspi3;

TIM_HandleTypeDef htim1;
TIM_HandleTypeDef htim2;
TIM_HandleTypeDef htim3;
TIM_HandleTypeDef htim4;
TIM_HandleTypeDef htim5;

UART_HandleTypeDef huart2;

void SystemClock_Config(void);
static void MX_GPIO_Init(void);
static void MX_DMA_Init(void);
static void MX_ADC1_Init(void);
static void MX_SPI2_Init(void);
static void MX_TIM1_Init(void);
static void MX_TIM2_Init(void);
static void MX_TIM3_Init(void);
static void MX_USART2_UART_Init(void);
static void MX_SPI3_Init(void);
static void MX_TIM4_Init(void);
static void MX_TIM5_Init(void);
/**
  * @brief  The application entry point.
  * @retval int
  */
int main(void)
{
  /* MCU Configuration--------------------------------------------------------*/

  /* Reset of all peripherals, Initializes the Flash interface and the Systick. */
  HAL_Init();

  /* Configure the system clock */
  SystemClock_Config();

  /* Initialize all configured peripherals */
  MX_GPIO_Init();
  MX_DMA_Init();
  MX_ADC1_Init();
  MX_SPI2_Init();
  MX_TIM1_Init();
  MX_TIM2_Init();
  MX_TIM3_Init();
  MX_USART2_UART_Init();
  MX_SPI3_Init();
  MX_TIM4_Init();
  MX_TIM5_Init();
  /* USER CODE BEGIN 2 */
  HAL_ADC_Start_DMA(&hadc1, (uint32_t*)adc_raw, 5);
  HAL_TIM_Base_Start(&htim2);
  HAL_TIM_Base_Start_IT(&htim4);
  HAL_TIM_Base_Start_IT(&htim5);
  int mode = 0;
  imu_init();
  init_maze();

  /* USER CODE END 2 */

  /* Infinite loop */
  /* USER CODE BEGIN WHILE */
  while (1)
  {
    switch (mode) {
      case 1:
        if (HAL_GPIO_ReadPin(SW1_GPIO_Port, SW1_Pin) == 0) {
          led_control(0xF);
          HAL_Delay(4000);
          led_control(0x0);
					angle_measured = 0;
					mypos.x = mypos.y = 0;			//座標を初期化
					mypos.dir = north;			//方角を初期化
          search_adachi(7, 7, 0.3, 1.0, 270.0, 270.0);
					//turn(180,TURN_ACCEL,TURN_SPEED,RIGHT);			//ゴールしたら180度回転する
					// mypos.dir = (mypos.dir+6) % 4;		//方角を更新
					// map_write();
					HAL_Delay(100);
					//search_adachi(0,0);			//スタート地点まで足立法で帰ってくる
					//turn(180,TURN_ACCEL,TURN_SPEED,RIGHT);			//帰ってきたら180度回転	
					// map_write();
          
        }
        break;
      case 2:
        if (HAL_GPIO_ReadPin(SW1_GPIO_Port, SW1_Pin) == 0) {
          led_control(0xF);
          HAL_Delay(4000);
          led_control(0x0);
					angle_measured = 0;
					mypos.x = mypos.y = 0;			//座標を初期化
					mypos.dir = north;			//方角を初期化
          search_adachi(7, 7, 0.5, 1.0, 270.0, 270.0);
					HAL_Delay(100);
        }
        break;
      case 3:
        if (HAL_GPIO_ReadPin(SW1_GPIO_Port, SW1_Pin) == 0) {
          led_control(0xF);
          HAL_Delay(4000);
          led_control(0x0);
					angle_measured = 0;
					mypos.x = mypos.y = 0;			//座標を初期化
					mypos.dir = north;			//方角を初期化
          search_adachi(7, 7, 0.7, 1.2, 270.0, 270.0);
					HAL_Delay(100);
        }
        break;
      case 4:
        if (HAL_GPIO_ReadPin(SW1_GPIO_Port, SW1_Pin) == 0) {
          led_control(0xF);
          HAL_Delay(4000);
          led_control(0x0);
					angle_measured = 0;
					mypos.x = mypos.y = 0;			//座標を初期化
					mypos.dir = north;			//方角を初期化
          search_adachi(7, 7, 1.0, 1.2, 270.0, 270.0);
					HAL_Delay(100);
        }
        break;
      case 5:
        if (HAL_GPIO_ReadPin(SW1_GPIO_Port, SW1_Pin) == 0) {
          led_control(0xF);
          HAL_Delay(4000);
          led_control(0x0);
					angle_measured = 0;
					mypos.x = mypos.y = 0;			//座標を初期化
					mypos.dir = north;			//方角を初期化
          search_adachi(7, 7, 1.2, 1.5, 270.0, 270.0);
					HAL_Delay(100);
        }
        break;
      case 6:
        if (HAL_GPIO_ReadPin(SW1_GPIO_Port, SW1_Pin) == 0) {
          HAL_Delay(1000);
          straight(SECTION * 5.0, 0.3, 1.0, 0);
        }
        break;
      case 7:
        if (HAL_GPIO_ReadPin(SW1_GPIO_Port, SW1_Pin) == 0) {
          HAL_Delay(1000);
          turn(90.0, 270.0, 270.0, LEFT);
          turn(90.0, 270.0, 270.0, LEFT);
          turn(90.0, 270.0, 270.0, LEFT);
          turn(90.0, 270.0, 270.0, LEFT);
        }
        break;
      case 8:
        if (HAL_GPIO_ReadPin(SW1_GPIO_Port, SW1_Pin) == 0) {
          HAL_Delay(1000);
          turn(90.0, 270.0, 270.0, RIGHT);
          turn(90.0, 270.0, 270.0, RIGHT);
          turn(90.0, 270.0, 270.0, RIGHT);
          turn(90.0, 270.0, 270.0, RIGHT);
        }
        break;
      case 9:
        if (HAL_GPIO_ReadPin(SW1_GPIO_Port, SW1_Pin) == 0) {
          HAL_Delay(1000);
          straight(HALF_SECTION, 1.0, 0.3, 0);
          straight(SECTION, 1.0, 0.3, 0);
          straight(SECTION, 1.0, 0.3, 0);
          straight(SECTION, 1.0, 0.3, 0);
        }
        break;
      case 10:
        if (HAL_GPIO_ReadPin(SW1_GPIO_Port, SW1_Pin) == 0) {
          HAL_Delay(1000);
          straight(HALF_SECTION, 1.0, 0.3, 0.3);
          straight(SECTION, 1.0, 0.3, 0.3);
          straight(SECTION, 1.0, 0.3, 0.3);
          straight(SECTION, 1.0, 0.3, 0.3);
        }
        break;
    }
    if (HAL_GPIO_ReadPin(SW0_GPIO_Port, SW0_Pin) == 0) {
      mode++;
      HAL_Delay(500);
    }
    if (HAL_GPIO_ReadPin(SW2_GPIO_Port, SW2_Pin) == 0) {
      mode--;
      HAL_Delay(500);
    }
    if (mode > 15) {
      mode = 0;
    }
    if (mode < 0) {
      mode = 15;
    }
    led_control(mode);
    HAL_Delay(100);
    /* USER CODE END WHILE */

    /* USER CODE BEGIN 3 */
  }
  /* USER CODE END 3 */
}

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
