Kuwamai/micromouse_ocelli/program/mouse_program/mouse_program.ioc

Mcu.UserName=STM32F405RGTx
PA0-WKUP.GPIO_Label=RIGHT_SIDE_IR
PA0-WKUP.Signal=GPIO_Output
PA1.GPIO_Label=RIGHT_FRONT_IR
PA1.Signal=GPIO_Output
PA10.Signal=GPIO_Output
PA11.Signal=S_TIM1_CH4
PA13.Signal=SYS_JTMS-SWDIO
PA14.Signal=SYS_JTCK-SWCLK
PA2.Signal=USART2_TX
PA3.Signal=USART2_RX
PA8.Signal=GPIO_Output
PA9.Signal=S_TIM1_CH2
PB0.Signal=ADCx_IN8
PB1.Signal=ADCx_IN9
PB10.Signal=SPI2_SCK
PB11.GPIO_Label=LEFT_FRONT_IR
PB11.Signal=GPIO_Output
PB12.GPIO_Label=LEFT_SIDE_IR
PB12.Signal=GPIO_Output
PB13.GPIO_Label=SW2
PB13.Signal=GPIO_Input
PB14.GPIO_Label=SW1
PB14.Signal=GPIO_Input
PB15.GPIO_Label=SW0
PB15.Signal=GPIO_Input
PB3.Signal=SYS_JTDO-SWO
PB5.GPIO_Label=BUZZER
PB5.Signal=S_TIM3_CH2
PC0.Signal=ADCx_IN10
PC1.GPIO_Label=SPI2_CS0
PC1.Signal=GPIO_Output
PC10.Signal=SPI3_SCK
PC11.Signal=SPI3_MISO
PC12.Signal=SPI3_MOSI
PC13-ANTI_TAMP.GPIO_Label=SPI2_CS1
PC13-ANTI_TAMP.Signal=GPIO_Output
PC2.Signal=SPI2_MISO
PC3.Signal=SPI2_MOSI
PC4.Signal=ADCx_IN14
PC5.Signal=ADCx_IN15
PC6.Signal=GPIO_Output
PC7.Signal=GPIO_Output
PC8.Signal=GPIO_Output
PC9.Signal=GPIO_Output
PD2.Signal=GPIO_Output
