Kuwamai/micromouse_ocelli/program/mouse_program/Core/Inc/main.h

#define SPI2_CS1_Pin GPIO_PIN_13
#define SPI2_CS1_GPIO_Port GPIOC
#define SPI2_CS0_Pin GPIO_PIN_1
#define SPI2_CS0_GPIO_Port GPIOC
#define RIGHT_SIDE_IR_Pin GPIO_PIN_0
#define RIGHT_SIDE_IR_GPIO_Port GPIOA
#define RIGHT_FRONT_IR_Pin GPIO_PIN_1
#define RIGHT_FRONT_IR_GPIO_Port GPIOA
#define LEFT_FRONT_IR_Pin GPIO_PIN_11
#define LEFT_FRONT_IR_GPIO_Port GPIOB
#define LEFT_SIDE_IR_Pin GPIO_PIN_12
#define LEFT_SIDE_IR_GPIO_Port GPIOB
#define SW2_Pin GPIO_PIN_13
#define SW2_GPIO_Port GPIOB
#define SW1_Pin GPIO_PIN_14
#define SW1_GPIO_Port GPIOB
#define SW0_Pin GPIO_PIN_15
#define SW0_GPIO_Port GPIOB
#define BUZZER_Pin GPIO_PIN_5
#define BUZZER_GPIO_Port GPIOB
