Kuwamai/micromouse_ocelli/program/mouse_program/Core/Inc/delay_us.h

/*
 * delay_us.h
 *
 *  Created on: Feb 3, 2023
 *      Author: kuwagata
 */

#ifndef INC_DELAY_US_H_
#define INC_DELAY_US_H_

void delay_us(uint16_t us);
void led_control(uint8_t led_state);
#endif /* INC_DELAY_US_H_ */
