Kuwamai/micromouse_ocelli/(commit log)

2022-07-06 ブロック図のフォーマット変更
2022-07-06 ブロック図を回路関係フォルダに移動
2022-07-06 ブロック図に型番記入
2022-07-20 KiCAD用gitignore追加
2022-07-21 KiCADプロジェクト作成
    [ocelli.kicad_pcb, ocelli.kicad_sch]
2022-07-21 フォトリフレクタ追加
    [ocelli.kicad_sch]
2022-07-26 モータドライバ追加
    [ocelli.kicad_sch]
2022-07-28 LED追加
    [ocelli.kicad_sch]
2022-08-03 IMUとか追加
    [ocelli.kicad_sch, untitled.kicad_sch]
2022-08-04 レイアウト調整
    [ocelli.kicad_sch]
2022-08-16 書き込みコネクタ追加
    [ocelli.kicad_sch]
2022-08-23 回路図PDF追加
    [ocelli.kicad_sch]
2022-08-23 スタイル調整
    [ocelli.kicad_sch]
2022-08-23 ラベル名変更
    [ocelli.kicad_sch]
2022-08-24 ブザー修正
    [ocelli.kicad_sch]
2022-08-24 文字位置修正
    [ocelli.kicad_sch]
2022-08-24 バッテリー電圧の表記追加
    [ocelli.kicad_sch]
2022-08-24 モータドライバプルアップ抵抗の削除
    [ocelli.kicad_sch]
2022-08-24 マイコン電源のパスコン追加
    [ocelli.kicad_sch]
2022-08-26 アノテーション実行
    [ocelli.kicad_sch]
2022-08-29 コンデンサの選定
    [ocelli.kicad_sch]
2022-08-30 抵抗の選定
    [ocelli.kicad_sch]
2022-08-31 距離センサ用抵抗の定格電力修正
    [ocelli.kicad_sch]
2022-09-01 CubeMXの出力追加
2022-09-03 フットプリント追加
    [ocelli.kicad_sch]
2022-09-05 使用するコンデンサを変更
    [ocelli.kicad_sch]
2022-09-09 フットプリント割当完了
    [ocelli.kicad_sch]
2022-09-14 基板外形追加、部品配置途中
    [ocelli.kicad_pcb, ocelli_board.dxf]
2022-09-16 モータマウント等のスケッチ追加
    [ocelli.kicad_pcb, ocelli.kicad_sch, ocelli_parts.dxf]
2022-09-16 エンコーダ基板投影図追加
    [ocelli.kicad_pcb, ocelli_parts.dxf]
2022-09-16 モータ位置変更
    [ocelli.kicad_pcb, ocelli_board.dxf, ocelli_parts.dxf]
2022-09-26 部品配置中
    [ocelli.kicad_pcb]
2022-10-17 一通りパターンを繋いだ
    [ocelli.kicad_pcb, ocelli.kicad_sch]
2022-10-21 対処すべきDRCエラーに対処した
    [ocelli.kicad_pcb, ocelli.kicad_sch]
2022-10-24 適当にビアを打ってみた
    [ocelli.kicad_pcb]
2022-10-26 アイコンシルク追加
    [ocelli.kicad_pcb]
2022-10-31 フットプリント修正
    [ocelli.kicad_pcb, ocelli.kicad_sch]
2022-11-08 バッテリコネクタ変更
    [ocelli.kicad_pcb]
2022-11-16 部品リスト追加
    [ocelli.kicad_sch]
2022-11-16 Gerberデータ追加
    [ocelli.GBL, ocelli.GBO, ocelli.GBS, ocelli.GTL, ocelli.GTO, ocelli.GTS]
2022-11-16 gerber設定追加
    [ocelli.kicad_pcb]
2022-12-28 Lチカコード
2022-12-28 古いプロジェクトを削除
2022-12-28 Lチカコード追加
2023-01-12 PWM出力によるモータの正転逆転の確認
2023-01-13 ピンアサイン修正
2023-01-16 WHO_AM_Iできた
2023-01-18 gitignore更新
2023-01-18 Z軸角速度が取得できた
2023-01-18 不要なファイルを削除
2023-01-24 角度が読めない
2023-01-26 for文の追加
2023-01-30 エンコーダの値を確認
2023-02-08 delay_us追加、壁センサの動作確認完了
2023-02-13 TIM4の割り込み設定
2023-02-14 割り込み関数で壁センサの取得
2023-02-16 速度制御実装 (#28)
    * 割り込み関数生成
    * 変数名変更
    * エンコーダ値を取得
    * エンコーダ値の変化量を取得
    * エンコーダ値を速度に変換
    * duty比の計算
    * PWM出力
    * 修正
    * 速度制御実装
    [global.c, global.h, main.c, mouse_program.ioc]
2023-02-17 台形速度制御 (#29)
    * 移動距離の計測
    * モード選択とLED制御実装
    * 台形速度制御関数追加
2023-02-18 台形角速度制御実装 (#30)
    * 角度計測
    * imu初期化関数
    * 電圧監視
    * コメント追加
    * 角速度制御
    * 角速度制御のゲインをいい感じにした
    * 旋回関数
2023-02-18 バッテリーが切れそうになったらLEDを点滅
2023-02-18 壁制御 (#32)
    * センサ値を構造体で管理
    * コミット忘れ
    * 壁の有無判定
    * 不要な変数を削除
    * 壁制御偏差算出
    * 壁制御実装
    * 壁がないときは制御しない
2023-02-21 足立法 (#33)
    * HM-Kit足立法移植中
    * マップの初期化を忘れていた。走るようになってきた
    * ゲイン調整
    * 前壁が近いときは壁制御しない
    * タイヤ直径とか調節した
    * 移動平均フィルター使ったらセンサノイズ減った。迷路サイズ小さくしたら処理が軽くなった?
    * 全日本大会用調整
2023-04-26 計測距離のリセットタイミング修正 (#39)
    * パラメータ調整
    * 不要な走行距離計算を削除
    * 移動距離のリセットタイミングを修正
    * 走行中にモータをOFFにする不具合修正
    * 実験用迷路ゴール位置設定
    [global.c, main.c, run.c]
2023-04-26 doubleの数値をfloatに変更
2023-04-28 社内大会用パラメータ
2023-12-20 kicad 7対応
2023-12-20 探索用コード作成
