Kuwamai/micromouse_ocelli/(notices)

Notices in the files:
program/mouse_program/Core/Inc/main.h:
Copyright (c) 2022 STMicroelectronics.
All rights reserved.
This software is licensed under terms that can be found in the LICENSE file
